Lengff/esp8266-lattice-clock-open/img/3.png

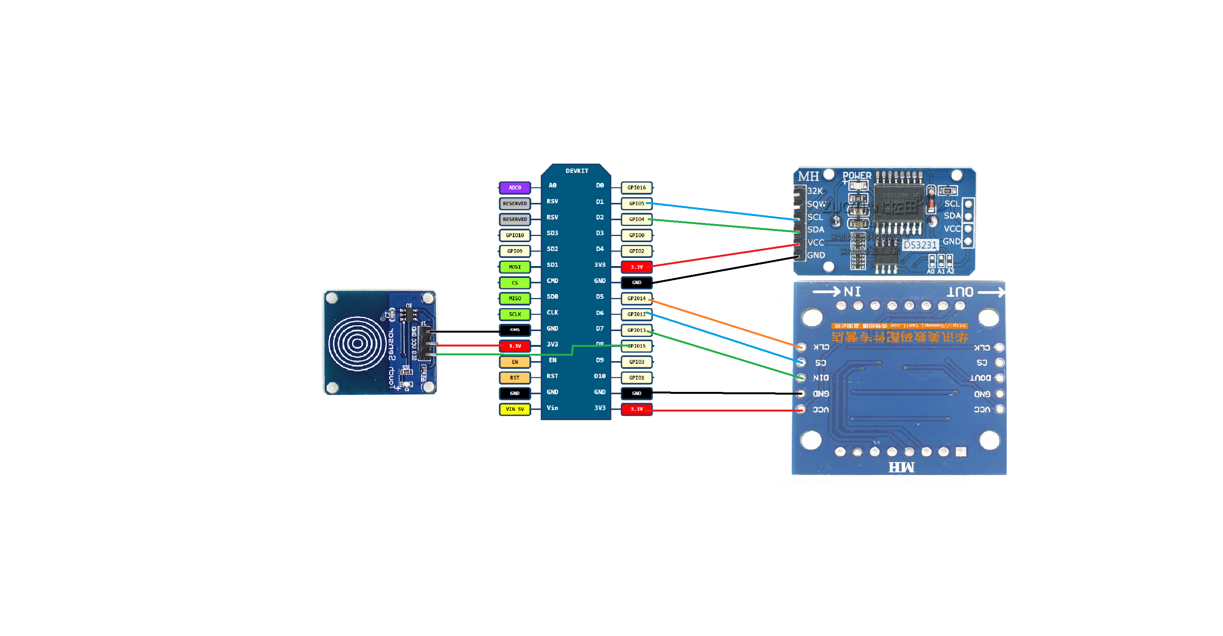
img/3.png
