Lengff/esp8266-lattice-clock-open/(commit log)

2022-01-17 init 初始化代码
2022-01-20 feat 添加readme
2022-01-20 feat 新增加一种时间显示方式
2022-02-10 feat 新增倒计时功能
2022-02-19 feat 新增一些功能 1. 新增LED指示灯，实现交互配置指示灯知道设备状态 2. 新增热点连接模式，可以通过小程序连接设备热点进行交互，脱离wifi的限制 3. 修复NTP校准时间时重启的bug，同时也支持热点模式下的时间校准 4. 优化wifi账号密码的功能，esp8266会自己去存wifi账号密码,所以我就删除原本自己处理的部分 5. 修复自定义显示的bug 6. 删除部分串口打印功能
    [EEPROMTool.h, HttpTool.cpp, Lattice.cpp, Otas.h, PilotLight.cpp, PilotLight.h, Touch.h, Udps.cpp]
2022-02-19 fix 更换新 的固件
2022-02-28 fix 增加亮度和屏幕方向固定的功能
2022-03-01 fix 1. 针对wifi连接失败做处理(1. 如果60秒都连不上wifi就不连了, 2.优化热点连接的问题) fix 2. 优化代码 fix 3. 修复bug
    [EEPROMTool.h, HttpTool.h, Lattice.cpp, Otas.h, esp8266-lattice-clock.ino, wifis.cpp, wifis.h]
2022-03-01 fix 更新说明文档
2022-03-03 feat 1. 优化了wifi连接:(如果1分钟内都连不上wifi,则自动进入到热点模式) 2. 支持方向,亮度等持久化(小程序设置过了以后就不会再重置了) 3. 新增休眠功能,可以设置指定时间段内设备显示亮度或者熄灭 4. 优化代码 5. 由于域名变更,之前代码固定的域名改变,所以部分功能低版本无法使用,所以就下架了此版本前的所有OTA
2022-03-27 add 新增接入点灯科技代码
2022-03-27 add 添加接入点灯科技的代码
2022-03-27 fix 添加接入点灯科技得代码
2022-03-27 fix 修复文档说明
2022-03-27 fix 修复文档图片不显示问题
2022-03-27 fix 修复文档
2022-04-05 add 新增无时钟芯片代码处理逻辑，如果没有连到时钟芯片，或者本就不想用时钟芯片，系统依旧可以正常运行
2022-04-05 fix 修改readme.md
2022-04-09 add 优化整体代码,修复一些bug(可能还有其他bug) 1. 添加无时钟芯片时钟代码 2. 优化按键逻辑,取消了长按功能(此功能容易引起误操作) 3. 修改配网方案,取消原来的配网方式,更换为现在的热点配网（连接时钟热点，自动弹出配网页面，即可配网） 4. 优化校准时间代码,确保NTP校准时间没啥问题
    [DateTimes.cpp, DateTimes.h, HttpTool.cpp, Lattice.cpp, Lattice.h, Ota.cpp, Otas.h]
2022-04-10 fix 叕重构代码了，将一些代码单独出来使用，增强面向对象的思路搞（虽然我也不知道适合不适合面向对象）
2022-04-10 fix 集成点灯科技的支持
2022-04-10 fix 右右右优化代码，提高设备发现速度，解决小程序很久识别不到设备的问题
2022-04-10 修改最新固件
2022-04-16 fix 优化eeprom读取方式
2022-05-01 feat 新增对awtirx的支持，如果温湿度传感器用的是HTU21D的话可以显示温度，增加几个简单的颜色变化，由于时间比较忙，所以就只简单适配一下代码，如果有兴趣的朋友可以自己修改代码
2022-05-01 fix 完善文档
2022-05-21 feat 增加对DHT11的支持,如果你用的时钟芯片的话,温度还是从DS3231中获取的
2022-05-21 fix 更新文档
2022-05-30 fix 优化了一波代码 1. 优化了一波代码 2. 去掉了之前的DHT11,采用新的DHT11的库 3. 增强代码可用性
    [DateTimes.cpp, DateTimes.h, Lattice.cpp, Lattice.h, LatticePlus.cpp, LatticePlus.h, Main.h, Ota.cpp]
2022-05-31 fix 修复时钟显示bug
2022-11-04 feat 增加光敏电阻，实现光线较低时自动息屏，亮度较高时亮屏 && ntp校准时间重试次数增加
    1. 增加光敏电阻，实现光线较低时自动息屏，亮度较高时亮屏
    2. ntp校准时间重试次数增加
2022-11-04 feat 增加代码说明
2022-11-04 fix 更新图片
2022-12-30 fix 修复代码问题
2023-01-05 完善点灯代码
2023-01-09 补上之前提交遗漏的代码
2023-06-12 修复bug
2023-06-12 提交代码
2023-07-07 fix 增加每天8点重新校准时间功能&&讲bilibili粉丝获取接口换成B站官方的
